Shayshez/Apex/README.md

# Apex
## CC-BY-SA 4.0
Rotatable Envelope/LFO/tap LFO/Drum generator, Based on MI "Peaks"

## ROTATABLE = Modules for 3u / 1u
Apex comes with 2 panels: 1u/20hp and 3u/6hp

Image of Apex
