Shayshez/Apex/Apex-BOM.xlsx

Qty | Value | Device | Package | Parts | Description | Source
2 | 33 (for switch led brightness, higher value = less bright) | R-US_R0603 | R0603 | R10, R23 | RESISTOR, American symbol | 603-RT0603FRE0733RL
5 | 100 (for led brightness, higher value = less bright) | R-US_R0603 | R0603 | R2, R4, R6, R7, R8 | RESISTOR, American symbol | 603-RT0603FRE07100RL
2 | 1.0k | R-US_R0603 | R0603 | R20, R31 | RESISTOR, American symbol | 603-RT0603FRE071KL
2 | 3.3k | R-US_R0603 | R0603 | R9, R25 | RESISTOR, American symbol | 603-RT0603FRE073K3L
4 | 10k | R-US_R0603 | R0603 | R3, R13, R16, R28 | RESISTOR, American symbol | 603-RT0603FRE0710KL
2 | 100k | R-US_R0603 | R0603 | R15, R27 | RESISTOR, American symbol | 603-RT0603FRE07100KL
6 | 39k | R-US_R0603 | R0603 | R12, R14, R17, R22, R24, R26 | RESISTOR, American symbol | 603-RT0603FRD0739KL
2 | 249k | R-US_R0603 | R0603 | R18, R29 | RESISTOR, American symbol | 594-MCT06030C2493FP5
2 | 309k | R-US_R0603 | R0603 | R19, R30 | RESISTOR, American symbol | 279-CPF0603F309KC1
4 | 18p | C-USC0603 | C0603 | C6, C7, C17, C23 | CAPACITOR, American symbol | 80-C0603C180J5GAUTO
4 | 220p | C-USC0603 | C0603 | C14, C15, C19, C20 | CAPACITOR, American symbol | 80-C0603C221J5G7411
10 | 100n | C-USC0603 | C0603 | C3, C5, C8, C9, C10, C12, C16, C18, C21, C24 | CAPACITOR, American symbol | 80-C0603C104M5RE7411
2 | 470n | C-USC0603 | C0603 | C11, C22 | CAPACITOR, American symbol | 963-UMK107BJ474KAHT
1 | 3.3u | C-USC0603 | C0603 | C13 | CAPACITOR, American symbol | 810-C1608X5R1E335KAC
3 | 22u | CPOL-USC | PANASONIC_C | C1, C2, C4 | POLARIZED CAPACITOR, American symbol | 667-EEE-FP1E220AR
1 | EMI Filter Bead | >= 2200 ohm | 603 | L1 | SMD EMI Suppression Ferrite Beads | 710-742792693
2 | 1N5819HW | DIODE-SOD123 | SOD123 | D1, D2 | DIODE | 621-1N5819HW-F
1 | LM4040B10 | LM4041B12DBZ | DBZ_R-PDSO-G3 | IC6 | PRECISION MICROPOWER SHUNT VOLTAGE REFERENCE | 595-LM4040C10IDBZR
1 | LM4040B25 | LM4041B12DBZ | DBZ_R-PDSO-G3 | IC2 | PRECISION MICROPOWER SHUNT VOLTAGE REFERENCE | 595-LM4040C25IDBZR
1 | 8MHz | CRYSTALHC49UP | HC49UP | Q1 | CRYSTAL | 815-ABLS2-8-D4Y-T
2 | HIGHLY_PB6149L | HIGHLY_PB6149L | HIGHLY_PB64149L | SW4, SW6 |  | https://www.aliexpress.com/item/32801694445.html
1 | STM32F103CBT6 | STM32F103CB | LQFP48 | UC1 |  | 511-STM32F103CBT6
1 | DAC8552 | DAC8552 | MSOP-8 | IC3 |  | 595-DAC8552IDGKT
2 | OPA2171 | TL072D | SO08 | IC4, IC5 | OP AMP | 595-OPA2171AID
1 | LM1117-3.3 | REG1117 | SOT223 | IC1 | 800mA and 1A Low Dropout (LDO) Positive Regulator | 926-LM1117MPX3.3NOPB
2 | MMBT3904 | MMBT3904LT1-NPN-SOT23-BEC | SOT23-BEC | Q2, Q3 | NPN Transistror | 863-MMBT3904LT1G
2 | Tact Switches | TAC_SWITCHPTH | TACTILE-PTH | SW1, SW2 | Momentary Switch | 612-TL1105SP-250
2 | Caps for switches |  |  |  |  | 612-1RWHT
4 | 10kB | POT_USVERTICAL_PS | ALPS_POT_VERTICAL_PS | R1, R5, R11, R21 |  | https://www.aliexpress.com/item/32766023946.html | or thonk: https://www.thonk.co.uk/shop/alpha-9mm-pots-vertical-t18/
4 | PJ301_THONKICONN | PJ301 | WQP_PJ_301M6 | J1, J2, J3, J4 |  | https://www.aliexpress.com/item/32919567094.html | or thonk: https://www.thonk.co.uk/shop/thonkiconn/
5 | LED 3mm FLAT TOP RED | LED3MM | LED3MM | LED1, LED2, LED3, LED4, LED5 | LED | https://www.aliexpress.com/item/1954971920.html
1 | M05X2MINIJTAG | M05X2MINIJTAG | 2X5-1.27 | JP2 | Header 5x2 | https://www.aliexpress.com/item/32965125663.html
1 | POWER | POWER | 2X05_SMT_HEADER | POWER! |  | https://www.ebay.com/itm/10pcs-2-40Pin-SMD-SMT-2-40Pin-Male-Double-Row-Pin-Header-Connector-2-54MM-Pitch/182570982083
