Shayshez/Apex/Apex3.brd

## EAGLE design Apex3.brd (2018-11-22)

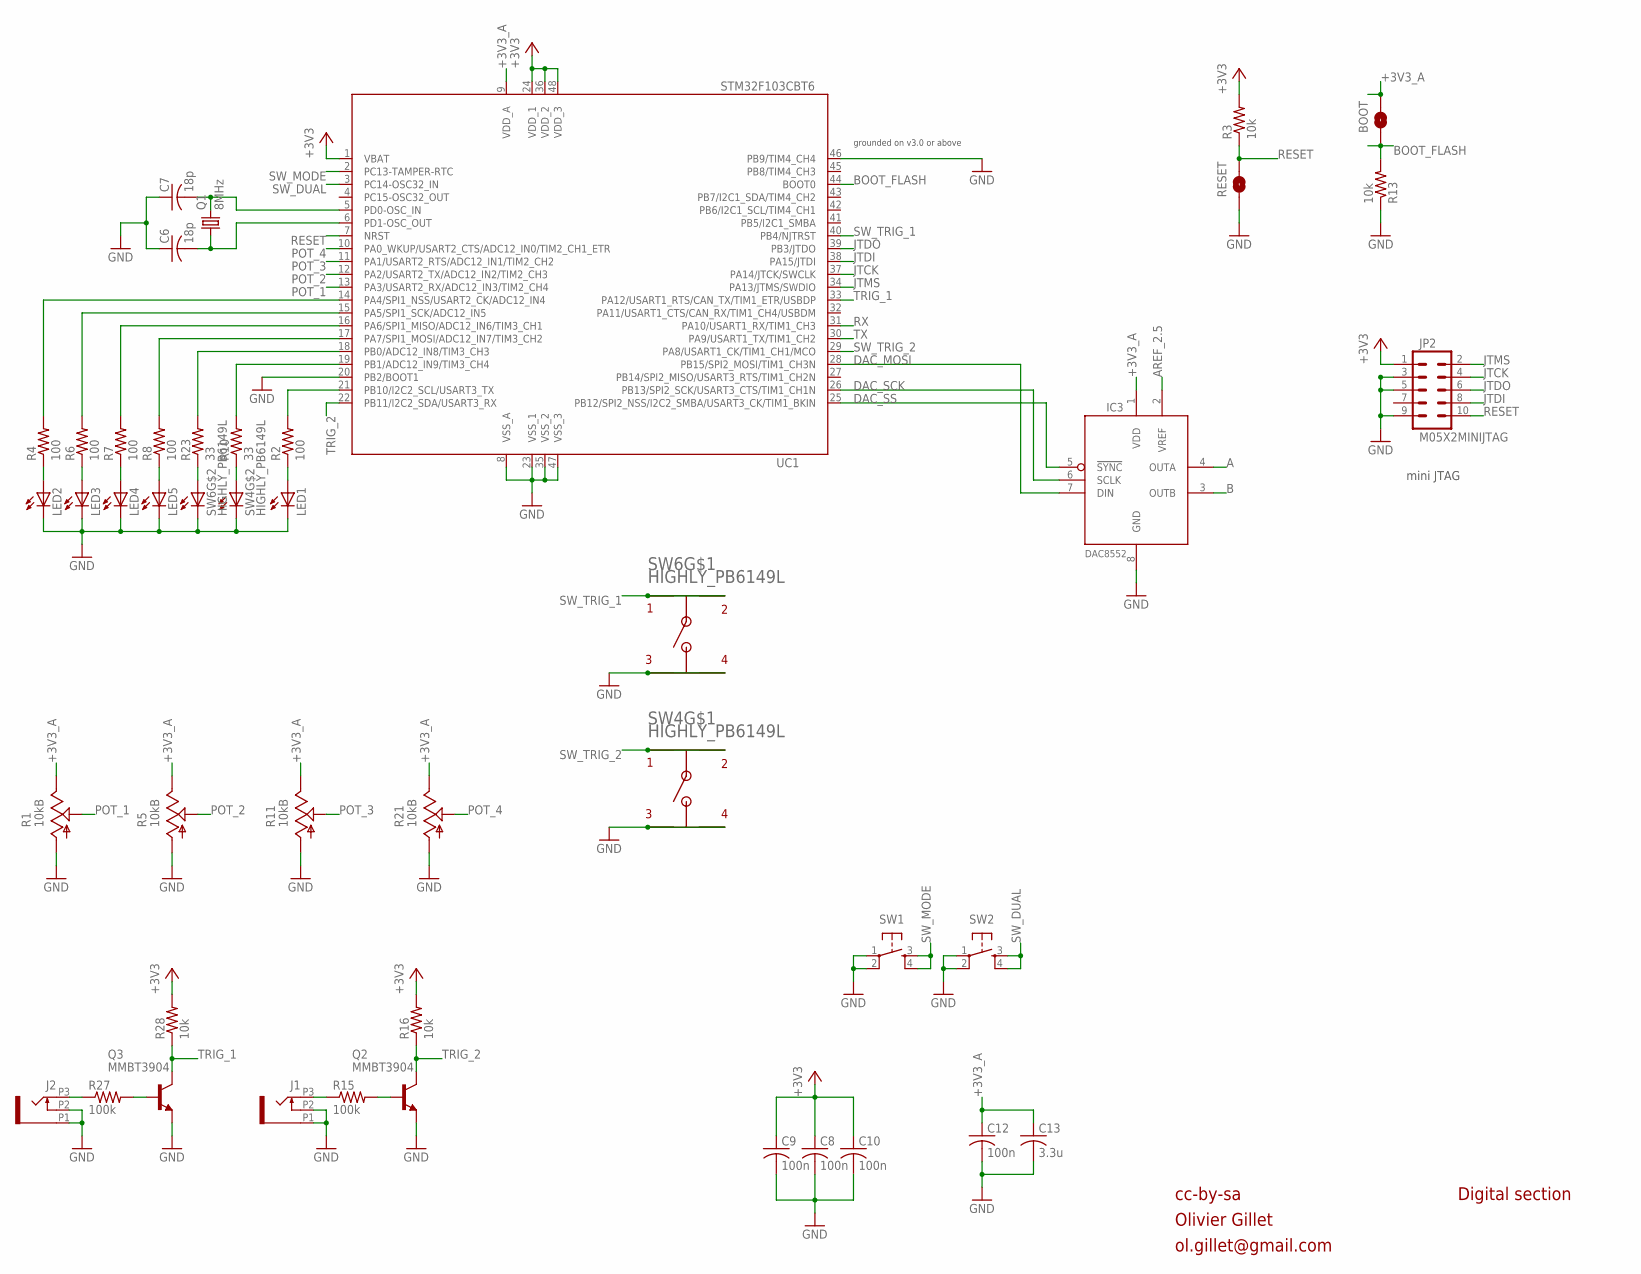
[picture p1: schematic Apex3.sch, sheet 1]

Parts:
BOOT: BOOT; SMT-JUMPER_2_NO_SILK
C6, C7: 18p; C0603
C8, C9, C10, C12: 100n; C0603
C13: 3.3u; C0603
IC3: DAC8552; MSOP-8
J1, J2: OG-PJ301_PJ301_THONKICONN; OG-PJ301_WQP_PJ_301M6_NO_HOLE
JP2: M05X2MINIJTAG; 2X5-1.27
LED1, LED2, LED3, LED4, LED5: LED3MM
Q1: 8MHz; HC49UP
Q2, Q3: MMBT3904; SOT23-BEC
R1, R5, R11, R21: 10kB; POT-ALPS_ALPS_POT_VERTICAL
R2, R4, R6, R7, R8: 100; R0603
R3, R13, R16, R28: 10k; R0603
R10, R23: 33; R0603
R15, R27: 100k; R0603
RESET: RESET; SMT-JUMPER_2_NO_SILK
SW1, SW2: TAC_SWITCHPTH; TACTILE-PTH
SW4, SW6: HIGHLY_PB6149L; HIGHLY_PB64149L
UC1: STM32F103CBT6; LQFP48

Connections:
+3V3: C8.1, C9.1, C10.1, JP2.1, R3.2, R16.2, R28.2, UC1.1 (VBAT), UC1.24 (VDD_1), UC1.36 (VDD_2), UC1.48 (VDD_3); also elsewhere on the board
+3V3_A: BOOT.2, C12.1, C13.1, IC3.1 (VDD), R1.P$1 (E), R5.P$1 (E), R11.P$1 (E), R21.P$1 (E), UC1.9 (VDD_A); also elsewhere on the board
A: IC3.4 (OUTA); also elsewhere on the board
AREF_2.5: IC3.2 (VREF); also elsewhere on the board
B: IC3.3 (OUTB); also elsewhere on the board
BOOT_FLASH: BOOT.1, R13.2, UC1.44 (BOOT0)
DAC_MOSI: IC3.7 (DIN), UC1.28 (PB15/SPI2_MOSI/TIM1_CH3N)
DAC_SCK: IC3.6 (SCLK), UC1.26 (PB13/SPI2_SCK/USART3_CTS/TIM1_CH1N)
DAC_SS: IC3.5 (!SYNC), UC1.25 (PB12/SPI2_NSS/I2C2_SMBA/USART3_CK/TIM1_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)
GND: C6.1, C7.1, C8.2, C9.2, C10.2, C12.2, C13.2, IC3.8 (GND), J1.P1 (1), J1.P2 (2), J2.P1 (1), J2.P2 (2), JP2.3, JP2.5, JP2.9, LED1.K (C), LED2.K (C), LED3.K (C), LED4.K (C), LED5.K (C), Q2.E, Q3.E, R1.P$3 (A), R5.P$3 (A), R11.P$3 (A), R13.1, R21.P$3 (A), RESET.1, SW1.1, SW1.2, SW2.1, SW2.2, SW4.L2, SW4.P$3, SW4.P$4, SW6.L2, SW6.P$3, SW6.P$4, UC1.8 (VSS_A), UC1.20 (PB2/BOOT1), UC1.23 (VSS_1), UC1.35 (VSS_2), UC1.46 (PB9/TIM4_CH4), UC1.47 (VSS_3); also elsewhere on the board
JTCK: JP2.4, UC1.37 (PA14/JTCK/SWCLK)
JTDI: JP2.8, UC1.38 (PA15/JTDI)
JTDO: JP2.6, UC1.39 (PB3/JTDO)
JTMS: JP2.2, UC1.34 (PA13/JTMS/SWDIO)
unnamed: J1.P3 (3), R15.1
unnamed: R23.2, UC1.18 (PB0/ADC12_IN8/TIM3_CH3)
unnamed: LED2.A, R4.1
unnamed: LED3.A, R6.1
unnamed: LED4.A, R7.1
unnamed: LED5.A, R8.1
unnamed: C7.2, Q1.2, UC1.5 (PD0-OSC_IN)
unnamed: C6.2, Q1.1, UC1.6 (PD1-OSC_OUT)
unnamed: R10.2, UC1.19 (PB1/ADC12_IN9/TIM3_CH4)
unnamed: R4.2, UC1.14 (PA4/SPI1_NSS/USART2_CK/ADC12_IN4)
unnamed: R6.2, UC1.15 (PA5/SPI1_SCK/ADC12_IN5)
unnamed: R7.2, UC1.16 (PA6/SPI1_MISO/ADC12_IN6/TIM3_CH1)
unnamed: R8.2, UC1.17 (PA7/SPI1_MOSI/ADC12_IN7/TIM3_CH2)
unnamed: Q2.B, R15.2
unnamed: R23.1, SW6.L1
unnamed: R10.1, SW4.L1
unnamed: LED1.A, R2.1
unnamed: R2.2, UC1.21 (PB10/I2C2_SCL/USART3_TX)
unnamed: J2.P3 (3), R27.1
unnamed: Q3.B, R27.2
POT_1: R1.P$2 (S), UC1.13 (PA3/USART2_RX/ADC12_IN3/TIM2_CH4)
POT_2: R5.P$2 (S), UC1.12 (PA2/USART2_TX/ADC12_IN2/TIM2_CH3)
POT_3: R11.P$2 (S), UC1.11 (PA1/USART2_RTS/ADC12_IN1/TIM2_CH2)
POT_4: R21.P$2 (S), UC1.10 (PA0_WKUP/USART2_CTS/ADC12_IN0/TIM2_CH1_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)
RESET: JP2.10, R3.1, RESET.2, UC1.7 (NRST)
RX: UC1.31 (PA10/USART1_RX/TIM1_CH3)
SW_DUAL: SW2.3, SW2.4, UC1.3 (PC14-OSC32_IN)
SW_MODE: SW1.3, SW1.4, UC1.2 (PC13-TAMPER-RTC)
SW_TRIG_1: SW6.P$1, SW6.P$2, UC1.40 (PB4/NJTRST)
SW_TRIG_2: SW4.P$1, SW4.P$2, UC1.29 (PA8/USART1_CK/TIM1_CH1/MCO)
TRIG_1: Q3.C, R28.1, UC1.33 (PA12/USART1_RTS/CAN_TX/TIM1_ETR/USBDP)
TRIG_2: Q2.C, R16.1, UC1.22 (PB11/I2C2_SDA/USART3_RX)
TX: UC1.30 (PA9/USART1_TX/TIM1_CH2)

Notes on the sheet:
cc-by-sa
Olivier Gillet
ol.gillet@gmail.com
Digital section
mini JTAG
grounded on v3.0 or above

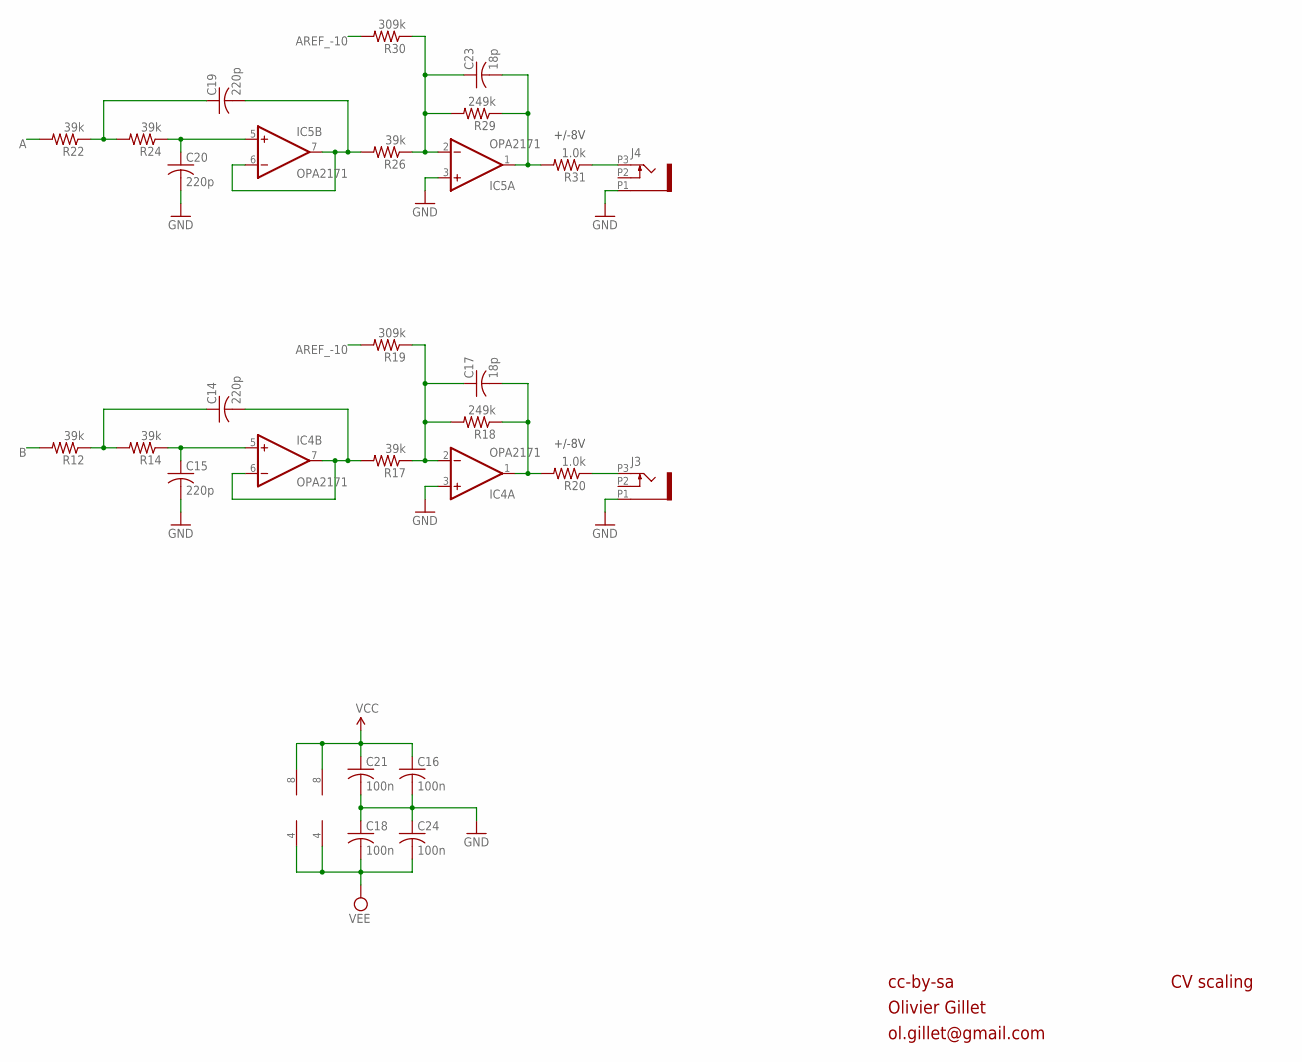
[picture p2: schematic Apex3.sch, sheet 2]

Parts:
C14, C15, C19, C20: 220p; C0603
C16, C18, C21, C24: 100n; C0603
C17, C23: 18p; C0603
IC4, IC5: OPA2171; SO08
J3, J4: OG-PJ301_PJ301_THONKICONN; OG-PJ301_WQP_PJ_301M6_NO_HOLE
R12, R14, R17, R22, R24, R26: 39k; R0603
R18, R29: 249k; R0603
R19, R30: 309k; R0603
R20, R31: 1.0k; R0603

Connections:
A: R22.2; also elsewhere on the board
AREF_-10: R19.2, R30.2; also elsewhere on the board
B: R12.2; also elsewhere on the board
BI_OUT: C17.2, IC4.1 (OUT), R18.1, R20.2
BI_OUT1: C23.2, IC5.1 (OUT), R29.1, R31.2
F_CV: C17.1, IC4.2 (-IN), R17.1, R18.2, R19.1
F_CV1: C23.1, IC5.2 (-IN), R26.1, R29.2, R30.1
GND: C15.2, C16.2, C18.1, C20.2, C21.2, C24.1, IC4.3 (+IN), IC5.3 (+IN), J3.P1 (1), J4.P1 (1); also elsewhere on the board
unnamed: C19.2, IC5.6 (-IN), IC5.7 (OUT), R26.2
unnamed: C20.1, IC5.5 (+IN), R24.1
unnamed: C19.1, R22.1, R24.2
unnamed: J3.P3 (3), R20.1
unnamed: J4.P3 (3), R31.1
unnamed: C14.2, IC4.6 (-IN), IC4.7 (OUT), R17.2
unnamed: C15.1, IC4.5 (+IN), R14.1
unnamed: C14.1, R12.1, R14.2
VCC: C16.1, C21.1, IC4.8 (V+), IC5.8 (V+); also elsewhere on the board
VEE: C18.2, C24.2, IC4.4 (V-), IC5.4 (V-); also elsewhere on the board

Notes on the sheet:
+/-8V
cc-by-sa
Olivier Gillet
ol.gillet@gmail.com
CV scaling

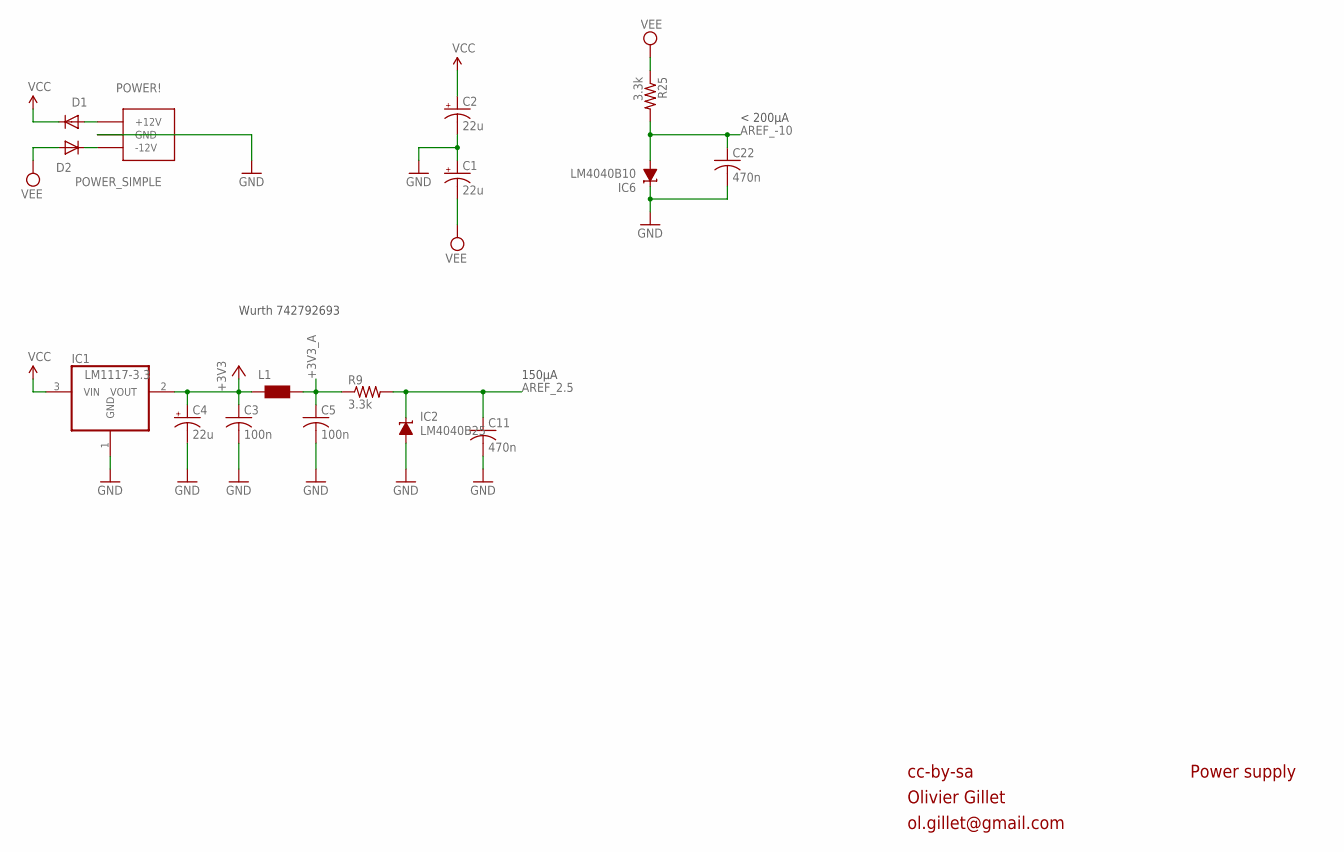
[picture p3: schematic Apex3.sch, sheet 3]

Parts:
C1, C2, C4: 22u; PANASONIC_C
C3, C5: 100n; C0603
C11, C22: 470n; C0603
D1, D2: 1N5819HW; SOD123
IC1: LM1117-3.3; SOT223
IC2: LM4040B25; DBZ_R-PDSO-G3
IC6: LM4040B10; DBZ_R-PDSO-G3
L1: WE-CBF_0603; 0603
POWER!: POWER_SIMPLE; 2X05_SMT_HEADER
R9, R25: 3.3k; R0603

Connections:
+3V3: C3.1, C4.+, IC1.2 (VOUT), L1.1; also elsewhere on the board
+3V3_A: C5.1, L1.2, R9.1; also elsewhere on the board
AREF_2.5: C11.1, IC2.1 (C), R9.2; also elsewhere on the board
AREF_-10: C22.1, IC6.2 (A), R25.2; also elsewhere on the board
GND: C1.+, C2.-, C3.2, C4.-, C5.2, C11.2, C22.2, IC1.1 (GND), IC2.2 (A), IC6.1 (C), POWER!.3 (GND), POWER!.4 (GND), POWER!.5 (GND), POWER!.6 (GND), POWER!.7 (GND), POWER!.8 (GND); also elsewhere on the board
unnamed: D1.A, POWER!.9 (+12V), POWER!.10 (+12V)
unnamed: D2.C, POWER!.1 (-12V), POWER!.2 (-12V)
VCC: C2.+, D1.C, IC1.3 (VIN); also elsewhere on the board
VEE: C1.-, D2.A, R25.1; also elsewhere on the board

Notes on the sheet:
cc-by-sa
Olivier Gillet
ol.gillet@gmail.com
Power supply
Wurth 742792693
< 200µA
150µA

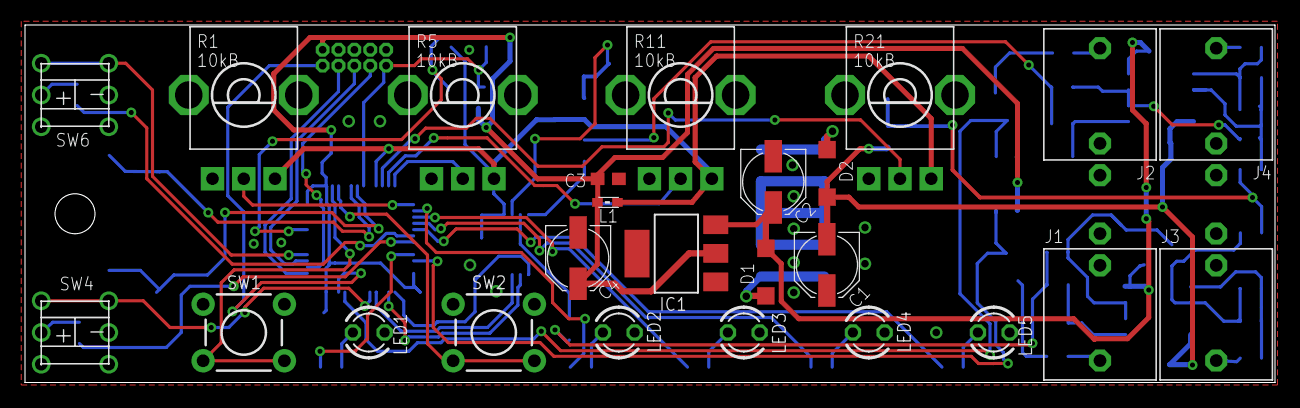
[picture p4: board Apex3.brd from above]

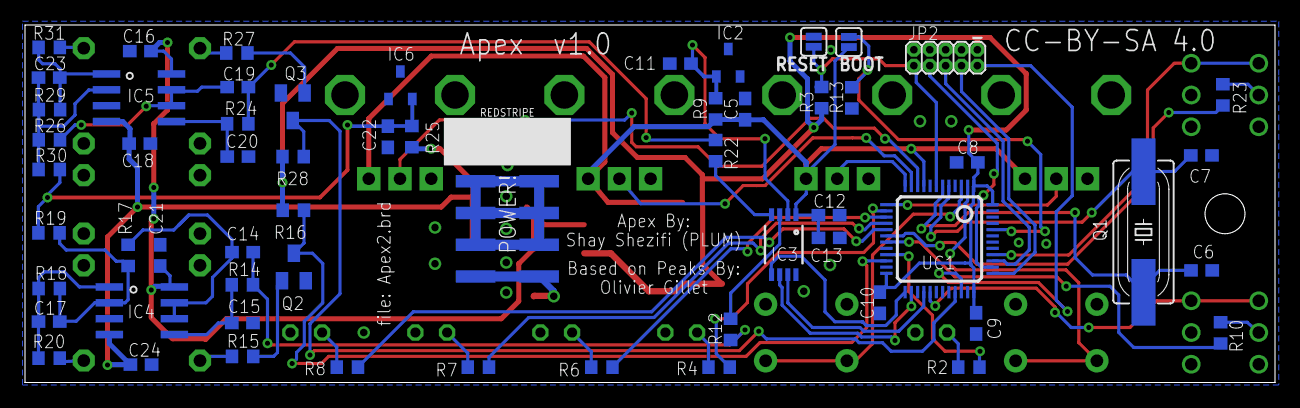
[picture p5: board Apex3.brd from below]

Board: 2 copper layers, 100.0 x 28.6 mm, 85 parts (60 on the bottom side), 62 nets.
