Shayshez/Apex/(threads)

Thread 1 (2019-03-19):

Apex BOM queries.

Pipstapee, 2019-03-19:
I'm having a few issues with the parts listed on the Apex BOM.
I normally get all my parts from Mouser, for your Temps and wavelets modules, but I've noticed there are no mouser listed codes in the BOM and I'm new to SMD and don't want to bough the wrong parts. Have you a BOM with mouser part numbers or is it possible to add them?
The main issues encountered is, what type of EMI bead, the buttons as well as other items. I've refered to previous BOM on Plum modules I've built but again, I wouldn't want to buy the wrong part.
Thank you for your time.
Keep up the good work.

Thread 2 (2019-06-30):

digital noise will get the sound of Drum on ch1.

Z-Hyper, 2019-06-30:
I assembled Apex.
The firmware installed DMC + Calibration.
I took a video as I checked and found only one problem.
If you set Expert Mode and set ch1 to FM Drum and ch2 to Random Snare, digital noise will get the sound of Drum on ch1.
There is no noise in other combinations.
I have installed and tested a regular DMC 0.7 farm to try and have no noise in that case.
So I think that the cause is in the calibration firmware.
