Shayshez/Apex/(commit log)

2019-02-05 Rename Firmware/DMC + Calobration/peaks_bootloader_DMC_with_calibn.hex to Firmware/DMC + Calibration/peaks_bootloader_DMC_with_calibn.hex
2019-02-05 Rename Firmware/DMC + Calibration/peaks_bootloader_DMC_with_calibn.hex to Firmware/DMC+Calibration/peaks_bootloader_DMC_with_calibn.hex
